SamahAyman/IBEX-based-SoC/MS2/Report_milestone 2.pdf

# IBEX based SoC - MILESTONE 2

Ali Ghazal | 900171722
Samah Ayman | 900171848
Israa Fahmy | 900171831
Sarah Ali | 900172348

### 1. PLAN:

STEP 1: Collecting the needed tools. More on this in the tools sections [DONE]
STEP 2: Exploring those tools [undergoing ]
STEP 3: Understanding the SoC architecture [undergoing ]
STEP 4: Searching for the needed missing modules [undergoing]
STEP 5: Connecting everything together [undergoing ]
STEP 6: OPENLANE FLOW [undergoing ]
STEP 7: OPENLANE EXPLORATION
STEP 8: Interfacing IBEX core with AHB bus [undergoing]
STEP 9: Interfacing IBEX core with the reset of the SocGen RTL-generated modules
STEP 10: Final Simulation of the SoC on Caravel Chip

Between all steps, we are doing verification whenever possible

### 2. Tools:

### 3. Progress:

SoC GEN:

1. We read the slides and watched the tutorials posted on github
2. We experimented with the basic flow of the program
a. By modifying the JSON format of IPs, Masters ...
b. By trying to understand the hierarchy of the output and functionality of each module
3. We produced the N5 demo project and tried hardening it using open lane

IBEX:
1. We read its documentation available on GitHub.
2. We explored the RTL models of IBEX core, the integration module, and
SoC GEN | Generating components for the SoC.
OPENLANE | Automated RTL to GDS-II flow based on OpenROAD, Yosys, Magic, Netgen, Fault and custom methodology scripts for design exploration and optimization.
IBEX | The main CPU component.
SV2V | Transforming from IBEX’ SystemVerilog to verilog to be compatible with Yosys.

tried to formulate a good understanding of the integration module parameters and interfaces.
3. We used the default parameters for the integration module during our synthesis (default parameter for the register file: RegFileFF, for example). In order to do so:
- Firstly we converted the SystemVerilog RTLs to Verilog in order to be compiled by Yosys.
- Secondly, we ran OpenLANE on the Verilog RTLs of IBEX core for the synthesis step.
- We got the timing analysis from OpenSTA
- The point at which the synthesis fails is the OpenROAD step.

### 4. Problems (solved)

- Yosys does not completely support SystemVerilog so we needed to convert from SystemVerilog to Verilog using SV2V.
- We did this using sv2v .. to automate the tool and account for the dependencies we wrote a bash script based on ibex_yosys_syn:

This generated the needed Verilog files.

And we tried synthesizing those files with yosys.
- Script for the config.tcl for IBEX:

for file in ../rtl/*.sv; do module=`basename -s .sv $file` sv2v \
--define=SYNTHESIS \
../rtl/*_pkg.sv \
-I../vendor/lowrisc_ip/prim/rtl \ $file \
$LR_SYNTH_OUT_DIR/generated/${module}.v done

# Design

set ::env(DESIGN_NAME) soc_m1_b1

set ::env(VERILOG_FILES) "[glob $::env(DESIGN_DIR)/src/*.v] [glob $::env(DESIGN_DIR)/src/*/*.v] [glob $::env(DESIGN_DIR)/src/*/*/*.v]"

set ::env(CLOCK_PERIOD) "14"
set ::env(CLOCK_PORT) "HCLK"

### 5. Problems (undergoing)

- During running OpenLANE, synthesis is failing as a result of combinational network error; the produced RTL models are combinational and they need to be logical instead to be synthesized.
- Information available regarding the field contents of the AHB bus is not sufficient. This is needed for designing the interface between the core and the bus generated by SoCGen.

### 6. Next step

- Understanding the SoC modules generated by SoCGen
- Designing the required interfaces between IBEX Core and the SoCGen modules
- Fixing the bugs occurring during hardening the IBEX core using OpenLANE (errors with OpenROAD step)

set ::env(CLOCK_NET) $::env(CLOCK_PORT)

set filename
$::env(DESIGN_NAME)/$::env(PDK)_$::env(STD_CELL_LIBRARY)_config .tcl
if { [file exists $filename] == 1} {
source $filename
}

### 7. Outputs

SoCGen output files

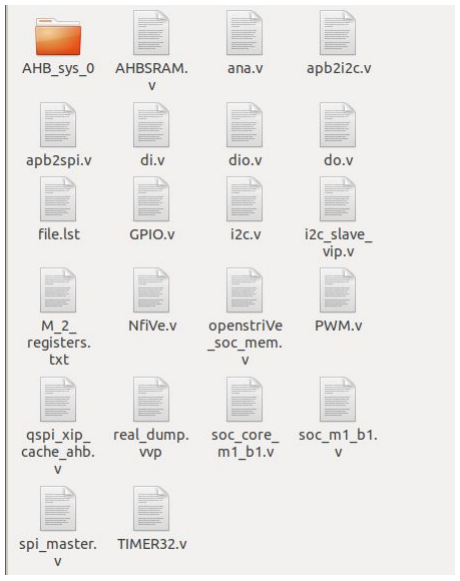
[picture p10: figure]
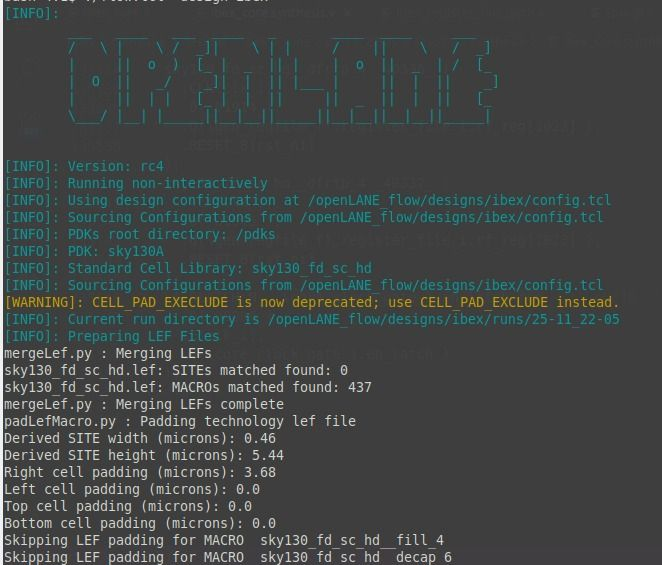
[picture p11: figure]

Running OpenLANE

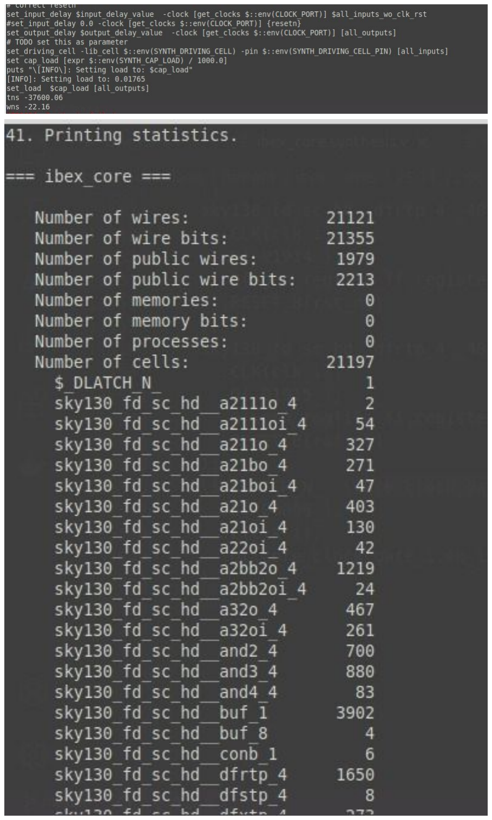
[picture p12: figure]

Comment: We tried to synthesize IBEX RTLs to generate a net list but turned out that there was a corrupted network inside the generated netlist that we are trying to allocate it originally inside the IBEX verilog files (Error: Combinational network).
