SamahAyman/IBEX-based-SoC/image/placement.png

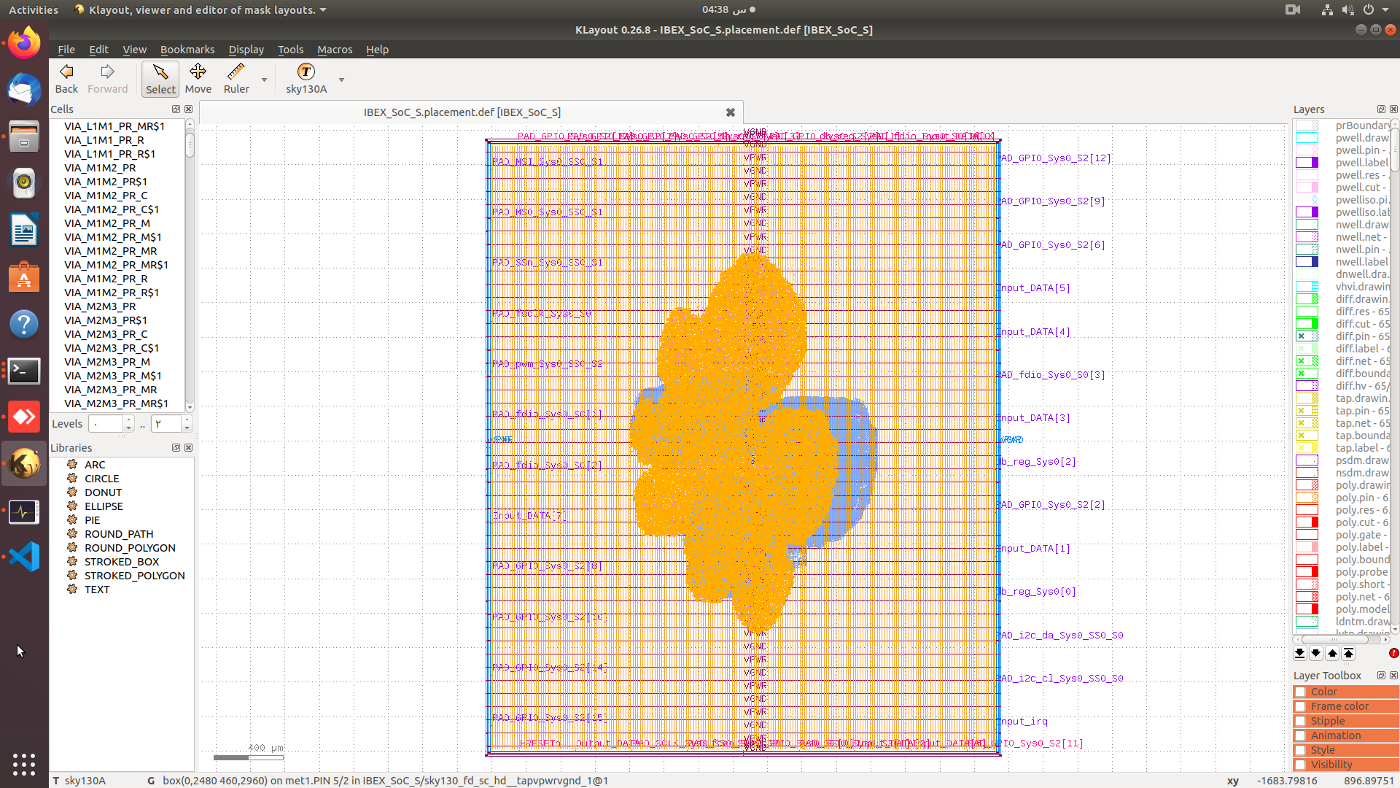
image/placement.png
