SamahAyman/IBEX-based-SoC/image/wrapper_BD.png

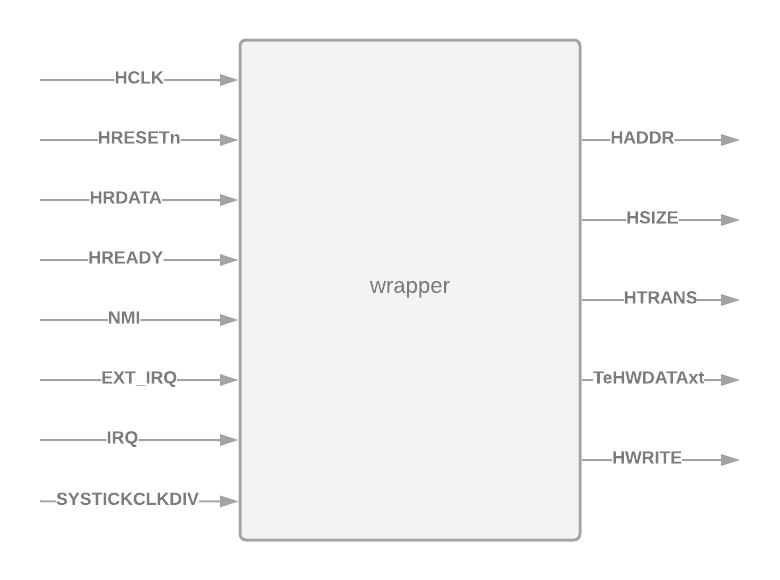
image/wrapper_BD.png
