SamahAyman/IBEX-based-SoC/MS3/testbench_images/tb_1.png

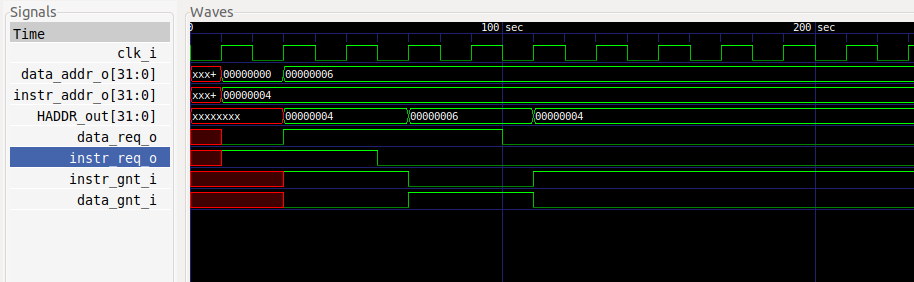
MS3/testbench_images/tb_1.png
