SamahAyman/IBEX-based-SoC/(commit log)

2020-12-02 n5 reports & interface
    [final_summary_report.csv]
2020-12-17 OPENLANE files
    [pin_order.cfg]
2020-12-19 adding ibex core gds file displayed on klayout
    [pin_order.cfg, tritonRoute.param]
